vb-projekts/ESP32_BatterieMonitor/Dokumentation/Dokumentation.docx

ESP32 Batterie-Monitor

Projektdokumentation

AZ-Delivery Mini D1 ESP32 | HC-SR04 Ultraschall | 1.30" OLED | Raspberry Pi 5

Erstellt: August 2026

# 1. Projektuberblick

Dieses Projekt realisiert einen mobilen Sensor-Monitor auf Basis eines ESP32-Mikrocontrollers. Der ESP32 wird uber ein DC-DC Buck-Converter-Modul von einer 12V Autobatterie versorgt und misst kontinuierlich Distanz (HC-SR04), Uptime und Batteriespannung. Die Daten werden auf einem OLED-Display angezeigt, uber einen lokalen Webserver bereitgestellt und alle 10 Sekunden an einen Raspberry Pi 5 gesendet, der eine Ubersichts-Webseite anzeigt.

## Komponenten

Komponente | Modell / Typ | Funktion
Mikrocontroller | AZ-Delivery Mini D1 ESP32 (WROOM-32) | Hauptcontroller
Display | 1.30" IIC OLED V2.1 (SH1106, 128x64) | Anzeige Uptime + IP
Ultraschallsensor | HC-SR04 / HC-SR04+ | Distanzmessung
Server | Raspberry Pi 5 (DietPi) | Datenempfang + Webseite
Stromversorgung | 24V/12V zu 5V 5A DC-DC Buck Converter | Spannungsversorgung vom Auto
Batterie | 12V Blei-Saure Autobatterie | Energiequelle

# 2. Hardware - Anschlussdiagramme

## 2.1 OLED Display (1.30" IIC V2.1)

Das Display kommuniziert uber den I2C-Bus. Alle 4 Pins direkt anschliessen - kein Spannungsteiler notig.

OLED Pin | ESP32 Pin | GPIO | Farbe (Empfehlung)
VDD | 3V3 | - | Rot
GND | GND | - | Schwarz
SCK | GPIO22 | SCL | Gelb
SDA | GPIO21 | SDA | Blau

Schaltplan:

ESP32 Mini D1 1.30" IIC OLED V2.1
+------------------+ +------------------+
| 3V3 -----------+-------------+-- VDD |
| GND -----------+-------------+-- GND |
| GPIO21 (SDA) ---+-------------+-- SDA |
| GPIO22 (SCL) ---+-------------+-- SCK |
+------------------+ +------------------+

## 2.2 HC-SR04 Ultraschallsensor

WICHTIG: Den ECHO-Pin pruefen!

HC-SR04+ (mit + oder P): direkt an 3.3V und GPIO anschliessbar

HC-SR04 (ohne +): 5V an VCC, ECHO-Pin benoetigt Spannungsteiler (100kOhm + 27kOhm)

HC-SR04 Pin | ESP32 Pin | GPIO | Hinweis
VCC | 3V3 oder 5V | - | HC-SR04+: 3.3V ok | HC-SR04: 5V benoetigt
GND | GND | - | Gemeinsame Masse!
TRIG | GPIO25 | Output | Direkt anschliessbar
ECHO | GPIO27 | Input | Bei 5V-Versorgung: Spannungsteiler verwenden

Schaltplan:

ESP32 Mini D1 HC-SR04
+------------------+ +------------------+
| 3V3/5V ---------+-------------+-- VCC |
| GND -----------+-------------+-- GND |
| GPIO25 (TRIG) --+-------------+-- TRIG |
| GPIO27 (ECHO) --+--[Teiler]---+-- ECHO |
+------------------+ +------------------+

Spannungsteiler (nur bei 5V-Variante):
ECHO (5V) --- 100kOhm --- GPIO27
|
27kOhm
|
GND

## 2.3 Batteriespannungsmessung (optional)

Misst die Batteriespannung (12V) sicher am ESP32 ADC (max. 3.3V) uber einen Spannungsteiler.

Bauteil | Wert | Anschluss | Zweck
R1 | 100 kOhm | Batterie (+) -> GPIO34 | Spannungsteiler oben
R2 | 27 kOhm | GPIO34 -> GND | Spannungsteiler unten
Zener-Diode | 3.3V | Parallel zu R2 | GPIO-Schutz vor Spannungsspitzen
Kondensator | 100 nF | Parallel zu R2 | Rauschfilter ADC
Messpunkt | GPIO34 | ADC1 - Channel 6 | ADC1 wegen WiFi-Kompatibilitaet!

Schaltplan:

Batterie (+) 12V
|
R1 100kOhm
|
+---------- GPIO34 (ESP32)
|
R2 27kOhm Zener 3.3V 100nF
| | |
GND +-----------+-----------+
(gemeinsame Masse = Buck Converter GND = ESP32 GND)

## 2.4 Stromversorgung - Buck Converter

Das DC-DC Modul wandelt 12V der Autobatterie in 5V USB fuer den ESP32 um.

Anschluss | Von | Nach | Hinweis
Buck IN+ | Batterie (+) | Buck Converter IN+ | Rohspannung 12V
Buck IN- | Batterie (-) | Buck Converter IN- | Gemeinsame Masse!
Buck OUT+ | Buck OUT+ | USB Kabel (+) | 5V stabilisiert
Buck OUT- | Buck OUT- | USB Kabel GND | Masse durchgeschleift
Spannungsteiler | Batterie (+) | R1 -> GPIO34 | VOR dem Buck abgreifen!

WICHTIG: Den Spannungsteiler direkt an der Rohspannung der Batterie anschliessen, NICHT nach dem Buck-Converter (dort waeren es nur noch 5V)!

# 3. Komplette Pin-Belegung ESP32

Ubersicht aller belegten Pins im Projekt:

GPIO | Funktion | Richtung | Angeschlossen an
GPIO21 | I2C SDA | Bidirektional | OLED SDA
GPIO22 | I2C SCL | Output | OLED SCK
GPIO25 | TRIG | Output | HC-SR04 TRIG
GPIO27 | ECHO | Input | HC-SR04 ECHO
GPIO34 | ADC Batterie | Input (ADC1) | Spannungsteiler R1/R2
3V3 | Versorgung | Power | OLED VDD, HC-SR04 VCC (nur HC-SR04+)
GND | Masse | Power | OLED GND, HC-SR04 GND, Spannungsteiler
5V/VIN | Versorgung | Power IN | Buck Converter OUT+ (via USB)

Bewusst NICHT verwendete Strapping-Pins (Boot-Konflikt vermeiden):

GPIO0, GPIO2, GPIO5, GPIO12, GPIO15 - diese Pins nicht fuer externe Komponenten verwenden!

# 4. Software - ESP32 Arduino Code

## 4.1 Verwendete Libraries

Library | Version | Installation | Zweck
U8g2 | 2.36.x | Arduino Library Manager | OLED Display Treiber (SH1106)
WiFi | 3.3.11 | Im ESP32 Core enthalten | WLAN Verbindung
WebServer | 3.3.11 | Im ESP32 Core enthalten | Lokaler HTTP Server
HTTPClient | 3.3.11 | Im ESP32 Core enthalten | HTTP POST an Raspberry Pi
Wire | 3.3.11 | Im ESP32 Core enthalten | I2C Kommunikation

## 4.2 Arduino IDE Einstellungen

Einstellung | Wert
Board | ESP32 Dev Module
Upload Speed | 115200
CPU Frequency | 240 MHz
Flash Frequency | 80 MHz
Flash Size | 4MB
Partition Scheme | Default 4MB with spiffs

WICHTIG: Board muss auf "ESP32 Dev Module" stehen, NICHT auf "D1_MINI32"! Der D1_MINI32 hat keinen Zugriff auf HTTPClient.h.

## 4.3 Konfiguration im Code

// WLAN
const char* ssid = "DeinNetzwerkName";
const char* password = "DeinPasswort";

// Raspberry Pi Server URL
const char* serverUrl = "http://192.168.178.46:5000/api/data";

// Sendeintervall (Millisekunden)
const unsigned long SEND_INTERVAL = 10000; // 10 Sekunden

// Pin-Definitionen
#define I2C_SDA 21 // OLED Daten
#define I2C_SCL 22 // OLED Takt
#define TRIG_PIN 25 // HC-SR04 Trigger
#define ECHO_PIN 27 // HC-SR04 Echo
#define BATT_PIN 34 // Batterie ADC (ADC1!)

// Spannungsteiler
#define R1 100000.0 // 100 kOhm
#define R2 27000.0 // 27 kOhm
#define KALI_FAKTOR 1.05 // Kalibrierung ADC

## 4.4 Funktionen im Code

Funktion | Beschreibung
messeDistanz() | HC-SR04 Messung, gibt Distanz in cm zurueck (-1 = kein Objekt)
messeBatterie() | 16x ADC messen + mitteln, Spannung zurueckrechnen
ladestandText(v) | Spannung in Ladezustand-Text umwandeln (100%, 75% etc.)
uptimeString() | millis() in HH:MM:SS Format umwandeln
sendeAnServer() | HTTP POST mit JSON-Daten an Raspberry Pi senden
handleRoot() | Lokale ESP32-Webseite mit allen Messwerten ausliefern

## 4.5 Ladezustand Autobatterie

Spannung | Ladezustand | Zustand
>= 12.7 V | 100% | Voll geladen
>= 12.4 V | 75% | Gut
>= 12.2 V | 50% | Mittel
>= 12.0 V | 25% | Schwach
>= 11.8 V | Schwach! | Bald leer
< 11.8 V | LEER! | Abschalten - Tiefentladung vermeiden!

# 5. Software - Raspberry Pi Server

## 5.1 Systemvoraussetzungen

Komponente | Version / Info
Betriebssystem | DietPi (Debian-basiert)
Python | 3.11 oder hoeher
Flask | Aktuell (via pip in venv)
Port | 5000 (TCP, muss im Netzwerk erreichbar sein)

## 5.2 Installation auf DietPi

Schritt-fuer-Schritt Installation per SSH:

# 1. python3-venv installieren
sudo apt install python3-venv -y

# 2. Projektordner anlegen
mkdir -p ~/esp32-monitor

# 3. Virtual Environment erstellen
python3 -m venv ~/esp32-monitor/venv

# 4. Virtual Environment aktivieren
source ~/esp32-monitor/venv/bin/activate

# 5. Flask installieren
pip install flask

# 6. server.py erstellen (Code einfuegen)
nano ~/esp32-monitor/server.py

# 7. Testen
python server.py
# -> Webseite: http://<Pi-IP>:5000

## 5.3 Autostart mit systemd

Service-Datei erstellen damit der Server automatisch nach Neustart startet:

# Service-Datei erstellen
sudo nano /etc/systemd/system/esp32-monitor.service

[Unit]
Description=ESP32 Monitor Server
After=network.target

[Service]
# Python aus der venv verwenden!
ExecStart=/home/dietpi/esp32-monitor/venv/bin/python /home/dietpi/esp32-monitor/server.py
WorkingDirectory=/home/dietpi/esp32-monitor
Restart=always
RestartSec=5
User=root

[Install]
WantedBy=multi-user.target

# Service aktivieren und starten
sudo systemctl daemon-reload
sudo systemctl enable esp32-monitor
sudo systemctl start esp32-monitor

# Status pruefen
sudo systemctl status esp32-monitor

# Logs anzeigen
sudo journalctl -u esp32-monitor -f

## 5.4 API Endpunkte

Endpunkt | Methode | Beschreibung
/ | GET | Webseite mit Ubersicht und Nachrichtentabelle
/api/data | POST | Empfangt JSON-Daten vom ESP32

## 5.5 JSON Format (ESP32 -> Pi)

{
"uptime": "00:12:34", // HH:MM:SS seit letztem Neustart
"uptime_ms": 754000, // Millisekunden seit Neustart
"distanz_cm": 42.5, // Distanz in cm (-1 = kein Objekt)
"batterie_v": 12.54, // Batteriespannung in Volt
"ip": "192.168.178.100" // IP-Adresse des ESP32
}

## 5.6 Haeufige Probleme und Loesungen

Problem | Ursache | Loesung
externally-managed-environment | DietPi Python 3.11+ | Virtual Environment (venv) verwenden
SyntaxError Non-UTF-8 | Datei nicht als UTF-8 gespeichert | Datei-Encoding in Editor auf UTF-8 stellen
Port 5000 nicht erreichbar | Firewall oder falscher Port | sudo ufw allow 5000 oder Port pruefen
ESP32 sendet nicht | Falsche Server-IP im Code | serverUrl im ESP32 Code pruefen

## 5.7 Aktualisierungen server.py

sudo systemctl restart esp32-monitor

# 6. Systemarchitektur

AUTOBATTERIE (12V)
|
+---- Buck Converter (12V -> 5V) ---- USB ----> ESP32
|
+---- Spannungsteiler (100k/27k) ------------> GPIO34 (ADC)

ESP32
|-- I2C (GPIO21/22) ----> OLED Display (Uptime + IP)
|-- GPIO25 (TRIG) ------> HC-SR04
|-- GPIO27 (ECHO) <------ HC-SR04
|-- GPIO34 (ADC) <------- Spannungsteiler Batterie
|
+-- WiFi
|
+-- HTTP GET / --> Lokale Webseite (Browser)
+-- HTTP POST /api/data --> Raspberry Pi :5000

RASPBERRY PI 5 (DietPi)
+-- Flask Server :5000
|
+-- /api/data <-- Empfaengt Daten vom ESP32 (alle 10s)
+-- / --> Webseite fuer Browser (Auto-Refresh 5s)

# 7. Wichtige Hinweise und Tipps

## 7.1 Sicherheit

- ESP32 GPIO-Pins vertragen maximal 3.3V! Nie 5V direkt anlegen.

- Batterie-Minus (GND) muss mit ESP32 GND verbunden sein (gemeinsame Masse).

- Spannungsteiler IMMER vor dem Buck-Converter an der Rohspannung abgreifen.

- Zener-Diode 3.3V am ADC-Pin schuetzt vor Spannungsspitzen der Batterie.

- Verpolungsschutz des Buck-Converters schuetzt das Modul, nicht den Spannungsteiler!

## 7.2 ADC Kalibrierung

Der ESP32 ADC ist von Haus aus ca. 5-10% ungenau. Vorgehen zur Kalibrierung:

1. Multimeter an die Batterie halten und echten Wert ablesen.

2. Angezeigten Wert auf der Webseite notieren.

3. KALI_FAKTOR im Code entsprechend anpassen: KALI_FAKTOR = Echter_Wert / Angezeigter_Wert

## 7.3 ADC2 nicht mit WiFi verwenden

Der ESP32 hat ADC1 (GPIO32-39) und ADC2. ADC2 ist gesperrt wenn WiFi aktiv ist! Deshalb GPIO34 (ADC1) fuer die Batteriemessung verwenden.

## 7.4 Strapping-Pins meiden

Folgende GPIOs beim Booten nicht belegen (fuehrt zu Upload-Fehlern):

GPIO0 (Flash-Modus), GPIO2, GPIO5, GPIO12, GPIO15

Symptom: "serial TX path seems to be down" beim Flashen.

## 7.5 5V Pin beim Flashen

Den 5V-Pin des ESP32 (= USB VBUS) beim Flashen nicht mit externen Verbrauchern belasten. Das kann den Upload unterbrechen. Sensor waehrend des Flashens abziehen oder auf 3.3V umstecken.

# 8. Dateien in diesem Projekt-Ordner

Datei | Beschreibung
Dokumentation.docx | Diese Dokumentation
Code/Uptime_Schall.ino | Arduino Code fuer den ESP32 (vollstaendig)
Code/server.py | Python Flask Server fuer den Raspberry Pi

# 9. Batteriespannungsmessung - Loetanleitung

Dieses Kapitel erklaert wie du das Spannungsteiler-Modul fuer die Batteriemessung zusammenlotest. Das Modul wird als kleine eigenstaendige Einheit aufgebaut und dann mit nur 3 Kabeln angeschlossen.

## 9.1 Benoetigt

Bauteil | Wert | Anzahl | Hinweis
Widerstand R1 | 100 kOhm | 1x | Farbringe: Braun-Schwarz-Gelb-Gold
Widerstand R2 | 27 kOhm | 1x | Farbringe: Rot-Violett-Orange-Gold
Zener-Diode | 3,3V (z.B. BZX55C3V3) | 1x | Auf Polaritaet achten! Ring = Kathode
Kondensator | 100 nF (= 0,1 uF) | 1x | Keramik-Typ: keine Polaritaet
Kabel rot | ~20 cm | 1x | Zum Batterie (+)
Kabel schwarz | ~20 cm | 1x | Zu GND
Kabel gelb | ~20 cm | 1x | Zu GPIO34 am ESP32
Lochrasterplatine | klein (ca. 3x2 cm) | 1x | Optional aber empfohlen

## 9.2 Schaltplan Gesamtuebersicht

Der Mittelpunkt (MP) ist die zentrale Loetstelle - dort treffen sich alle Bauteile:

Batterie (+) 12V
|
[R1 100kOhm]
|
MP ────────────────────────► GPIO34 (ESP32)
|
+----+----+----------+
| | |
[R2 27kOhm] [Zener 3,3V] [100nF]
| | |
GND GND GND

MP = Mittelpunkt (R1 + R2 + Zener + Kondensator + GPIO34-Kabel)
GND = Gemeinsame Masse (ESP32 GND = Buck Converter GND = Batterie Minus)

## 9.3 Schritt 1 - R1 und R2 in Reihe loeten

Loete ein Bein von R1 (100kOhm) direkt an ein Bein von R2 (27kOhm). Diese Verbindung ist der Mittelpunkt. Widerstande haben keine Polaritaet.

Batterie(+) MP GND
| | |
[freies Bein R1]──[R1 100kOhm]──[R2 27kOhm]──[freies Bein R2]
^
Hier zusammenloeten = Mittelpunkt!

Tipp: Kuerze die Beine der Widerstande auf ca. 5mm und verdrille sie miteinander bevor du sie lotest - das haelt besser und ist kompakter.

## 9.4 Schritt 2 - Zener-Diode anloeten

Die Zener-Diode kommt parallel zu R2 - also zwischen Mittelpunkt und GND.

WICHTIG - Polaritaet beachten!
Kathode (Ring/Strich auf dem Gehaeuse) --> zum Mittelpunkt (hoehere Spannung)
Anode (Seite ohne Ring) --> zu GND
Falsch herum = kein Schutz fuer den ESP32!

Einbaurichtung der Zener-Diode:

Mittelpunkt ──── Kathode [RING] ──|Z|── Anode ──── GND
^
Strich/Ring auf dem Bauteil
zeigt immer zur hoeher liegenden Spannung

Visuell auf dem Bauteil:
GND <── (kein Ring) ──[===|]── (Ring/Strich) ──> Mittelpunkt

## 9.5 Schritt 3 - Kondensator anloeten

Der 100nF Kondensator kommt ebenfalls zwischen Mittelpunkt und GND.

Keramik-Kondensator (kleines Scheibchen): KEINE Polaritaet - beliebig herum einloeten.
Elko (Zylinder mit Aufschrift): HAT Polaritaet! Minus-Bein (kuerzeres Bein / weisser Strich) zu GND.

Mittelpunkt ──┬── [R2 27kOhm] ── GND
├── [Zener 3,3V] ── GND
└── [100nF Kondensator] ── GND
|
└── Gelbes Kabel zu GPIO34

## 9.6 Schritt 4 - Kabel anloeten

Kabel | Loeten an | Anderes Ende | Hinweis
Rot | Freies Bein R1 | Batterie (+) / Buck IN+ | VOR dem Buck Converter!
Schwarz | Freies Bein R2 + alle GND-Punkte | ESP32 GND | Gemeinsame Masse!
Gelb | Mittelpunkt (MP) | GPIO34 am ESP32 | Das Messsignal

## 9.7 Fertiges Modul - Gesamtbild

ROTES KABEL
zum Batterie (+)
|
[R1 100kOhm]
|
+───────────────MP──────── GELBES KABEL zu GPIO34
| |
[Zener 3,3V] [R2 27kOhm]
| |
| [100nF]
| |
+───────────────+──────── SCHWARZES KABEL zu GND

## 9.8 Anschluss am ESP32 und Batterie

ESP32 Mini D1 Buck Converter / Batterie
+------------------+ +------------------+
| | | |
| GPIO34 <---------+-- Gelb | IN+ (12V) <------+-- Rot
| | | |
| GND <---------+-- Schwarz --+-- IN- (GND) |
| | | |
+------------------+ +------------------+

Erinnerung: Das rote Kabel MUSS an die Rohspannung der Batterie (12V) - also VOR dem Buck Converter. Nach dem Buck Converter waeren es nur 5V und die Messung wuerde keinen Sinn ergeben!

## 9.9 Kontrolle vor dem ersten Einschalten

- Zener-Diode richtig herum? (Ring/Kathode zum Mittelpunkt)
- Kondensator richtig herum? (nur bei Elko - Minus zu GND)
- Rotes Kabel an Batterie (+) VOR dem Buck Converter?
- Schwarzes Kabel an GND (= Buck Converter GND = ESP32 GND)?
- Gelbes Kabel an GPIO34 (nicht GPIO35, 36 oder andere)?
- Kein Kurzschluss zwischen Mittelpunkt und GND ohne Bauteile?

## 9.10 Kalibrierung nach dem Aufbau

Der ESP32 ADC ist ca. 5-10% ungenau. So kalibrierst du:

1. Multimeter an die Batterie halten und echten Wert ablesen (z.B. 12,54V)

2. ESP32 starten und auf der Webseite den angezeigten Wert notieren (z.B. 11,94V)

3. KALI_FAKTOR berechnen: 12,54 / 11,94 = 1,05

4. Im Arduino Code KALI_FAKTOR anpassen und neu flashen

5. Kontrollmessung: Jetzt sollten beide Werte uebereinstimmen

// Im Arduino Code anpassen:
#define KALI_FAKTOR 1.05 // = Echter_Wert / Angezeigter_Wert

// Beispielrechnung:
// Multimeter zeigt: 12,54V
// Webseite zeigt: 11,94V
// KALI_FAKTOR = 12,54 / 11,94 = 1,050

# 10. Einkaufsliste Batteriespannungsmessung - Reichelt Elektronik

Bewaehrte Einkaufsliste bei Reichelt Elektronik (Stand August 2026). Reichelt ermoeglicht stückgenaue Bestellung - ideal fuer Einzelprojekte.

Warum Reichelt statt Amazon?
- Stueckgenaue Bestellung - kein Zwang 100er-Pakete zu kaufen
- Alle 4 Bauteile zusammen: nur ca. 1,53 EUR (statt ~27 EUR bei Amazon)
- Metallschicht-Widerstaende mit 0,1% und 1% Toleranz verfuegbar
- Lieferzeit: 1-2 Werktage ab Lager

## 10.1 Bestelluebersicht

Menge | Artikel-Nr. | Beschreibung | Wert | Toleranz | Einzelpreis | Gesamt
3 | MPR 100K | Widerstand, Metallschicht, 100kOhm, 0207, 0,6W | 100 kOhm | 0,1% | 0,26 EUR | 0,78 EUR
3 | METALL 27,0K | Widerstand, Metallschicht, 27,0kOhm, 0207, 0,6W | 27 kOhm | 1% | 0,07 EUR | 0,21 EUR
3 | BZX 55C3V3 VIS | Zenerdiode, 3,3V, 0,5W, DO-35 | 3,3V | - | 0,04 EUR | 0,12 EUR
3 | C3Z5U 100NA50 | Vielschicht-Kerko, 100nF, 50V, 85°C | 100 nF | - | 0,14 EUR | 0,42 EUR

Gesamtpreis: ca. 1,53 EUR (je 3 Stueck - Ersatz inklusive!)

## 10.2 Detailbeschreibung der Artikel

R1 - MPR 100K | Widerstand 100kOhm Metallschicht

Eigenschaft | Wert
Artikel-Nr. | MPR 100K
Widerstandswert | 100 kOhm
Typ | Metallschicht - praezise und rauscharm
Leistung | 0,6W
Toleranz | 0,1% - extrem praezise
Verwendung | R1: oberer Widerstand (Batterie+ zum Mittelpunkt)
Farbringe | Braun-Schwarz-Gelb-Braun-Braun (100K, 0,1%)

R2 - METALL 27,0K | Widerstand 27kOhm Metallschicht

Eigenschaft | Wert
Artikel-Nr. | METALL 27,0K
Widerstandswert | 27 kOhm
Typ | Metallschicht - praezise und temperaturstabil
Leistung | 0,6W
Toleranz | 1% - 5x genauer als 5%-Variante
Verwendung | R2: unterer Widerstand (Mittelpunkt zu GND)
Farbringe | Rot-Violett-Orange-Braun (27K, 1%)
Vorteil vs. 5% | Messfehler max. +-0,04V statt +-0,2V - und guenstiger!

Vergleich: METALL 27,0K (1%) vs. 1W 27K (5%)
1W 27K (Metalloxyd, 5%): 0,19 EUR - Messfehler bis +-0,2V
METALL 27,0K (Metallschicht, 1%): 0,07 EUR - Messfehler bis +-0,04V
Fazit: Besser UND guenstiger - klare Empfehlung fuer METALL 27,0K!

Zener-Diode - BZX 55C3V3 VIS | 3,3V Zenerdiode

Eigenschaft | Wert
Artikel-Nr. | BZX 55C3V3 VIS
Zenerspannung | 3,3V
Leistung | 0,5W
Gehaeuse | DO-35 - kleines axiales Glasgehaeuse
Verwendung | Ueberspannungsschutz GPIO34 (parallel zu R2)
Einbau | POLARITAET! Ring/Strich = Kathode = zum Mittelpunkt

Merkhilfe: Schwarzer Ring = Kathode = zeigt zum Mittelpunkt
Seite ohne Ring = Anode = zeigt zu GND

Kondensator - C3Z5U 100NA50 | Vielschicht-Kerko 100nF

Eigenschaft | Wert
Artikel-Nr. | C3Z5U 100NA50
Kapazitaet | 100 nF = 0,1 uF
Spannungsfestigkeit | 50V
Temperatur | bis 85°C
Typ | Vielschicht-Keramik - keine Polaritaet!
Verwendung | Rauschfilter am ADC-Pin GPIO34 (parallel zu R2)
Einbau | Beliebig herum - kein Plus/Minus

## 10.3 Spannungsberechnung mit diesen Bauteilen

Kontrolle: Spannung an GPIO34 im sicheren Bereich (max. 3,3V)?

Batteriespannung | Spannung an GPIO34 | Sicher fuer ESP32?
10,5V (Tiefentladung) | 10,5V x 27k / 127k = 2,23V | Ja
11,8V (fast leer) | 11,8V x 27k / 127k = 2,51V | Ja
12,0V (25%) | 12,0V x 27k / 127k = 2,55V | Ja
12,7V (voll) | 12,7V x 27k / 127k = 2,70V | Ja
14,4V (beim Laden) | 14,4V x 27k / 127k = 3,06V | Ja - knapp unter 3,3V
15,0V (max. Ladung) | 15,0V x 27k / 127k = 3,19V | Ja - Zener greift ein

Fazit: Alle Bauteile perfekt gewaehlt!
- Beide Widerstaende Metallschicht: praezise und temperaturstabil
- Toleranz 0,1% + 1%: Messfehler max. +-0,04V vor Kalibrierung
- Selbst bei 15V Ladespannung bleibt GPIO34 unter 3,3V
- Gesamtkosten: nur 1,53 EUR fuer je 3 Stueck aller Bauteile

# 11. Display Ein/Aus Button auf der Webseite (v1.3)

Ab Version 1.3 kann das OLED-Display direkt ueber die Webseite des ESP32 ein- und ausgeschaltet werden. Das spart Strom und ist praktisch wenn das Display gerade nicht benoetigt wird.

Changelog:
v1.0 - Grundversion: Uptime, Distanz, Webserver
v1.1 - HTTP POST an Raspberry Pi
v1.2 - Batteriespannungsmessung
v1.3 - Display Ein/Aus Button auf Webseite <-- NEU

## 11.1 Funktionsprinzip

Der ESP32 bekommt zwei neue URL-Endpunkte. Beim Klick auf den Button ruft der Browser einen dieser Endpunkte auf, der ESP32 schaltet das Display und leitet den Browser zurueck zur Startseite.

Browser klickt "Ausschalten"
|
GET http://ESP32-IP/display/off
|
ESP32: u8g2.setPowerSave(1) --> Display physisch AUS
displayAn = false
Redirect zu "/"
|
Webseite zeigt: "AUS" + Button "Einschalten"

Browser klickt "Einschalten"
|
GET http://ESP32-IP/display/on
|
ESP32: u8g2.setPowerSave(0) --> Display physisch AN
displayAn = true
Redirect zu "/"
|
Webseite zeigt: "AN" + Button "Ausschalten"

u8g2.setPowerSave(1) schaltet das Display physisch aus - es verbraucht
dann kaum noch Strom. Ideal wenn der ESP32 an der Autobatterie laeuft!

## 11.2 Aenderungen im Code (Uebersicht)

Was | Wo im Code | Details
Globale Variable | Ganz oben bei Variablen | bool displayAn = true;
Handler-Funktion 1 | Neue Funktion handleDisplayOn() | setPowerSave(0), Redirect zu /
Handler-Funktion 2 | Neue Funktion handleDisplayOff() | setPowerSave(1), Redirect zu /
Routen registrieren | In setup() | server.on("/display/on/off", ...)
Button im HTML | In handleRoot() | Neue Card mit Status + Button
Loop absichern | Display-Update im loop() | && displayAn hinzugefuegt
POST erweitert | In sendeAnServer() | "display_an": true/false im JSON

## 11.3 Neue Code-Abschnitte

1. Globale Variable:

bool displayAn = true; // true = AN, false = AUS

2. Handler-Funktionen:

void handleDisplayOn() {
displayAn = true;
u8g2.setPowerSave(0); // Display einschalten
server.sendHeader("Location", "/");
server.send(302, "text/plain", "");
}

void handleDisplayOff() {
displayAn = false;
u8g2.setPowerSave(1); // Display ausschalten
server.sendHeader("Location", "/");
server.send(302, "text/plain", "");
}

3. Routen in setup():

server.on("/", handleRoot);
server.on("/display/on", handleDisplayOn);
server.on("/display/off", handleDisplayOff);
server.begin();

4. Loop absichern:

// Display nur aktualisieren wenn es AN ist:
if (jetzt - letzteAnzeige >= 500 && displayAn) {
// ... Display-Code unveraendert ...
}

5. Button-HTML (neue Card in handleRoot()):

// Display-Status Karte - zeigt AN oder AUS + passenden Button
if (displayAn) {
html += "<div class=\"card-value status-an\">AN</div>";
html += "<a href=\"/display/off\" class=\"btn btn-off\">Ausschalten</a>";
} else {
html += "<div class=\"card-value status-aus\">AUS</div>";
html += "<a href=\"/display/on\" class=\"btn btn-on\">Einschalten</a>";
}

## 11.4 Webseiten-Layout mit Button

+----------------------------------------------------+
| ESP32 Dashboard |
| * Live - aktualisiert alle 2s |
+----------------------------------------------------+
| +----------+ +----------+ +----------+ |
| | Uptime | | Distanz | | Batterie | |
| | 00:12:34 | | 42.5 cm | | 12.54V | |
| +----------+ +----------+ +----------+ |
| |
| +------------------+ |
| | Display | |
| | AN (gruen) | <-- Status |
| | [ Ausschalten ] | <-- Button |
| +------------------+ |
+----------------------------------------------------+

Nach Klick "Ausschalten":
| | AUS (rot) |
| | [ Einschalten ] | <-- Button gruen

## 11.5 URL-Endpunkte

URL | Aktion | Rueckgabe
/ | Webseite anzeigen | HTML Seite
/display/on | Display einschalten | Redirect zu /
/display/off | Display ausschalten | Redirect zu /

Tipp: Die URLs koennen auch direkt im Browser aufgerufen werden:
http://<ESP32-IP>/display/off --> Display sofort ausschalten
http://<ESP32-IP>/display/on --> Display sofort einschalten
Das funktioniert auch ohne die Webseite zu oeffnen!
