vb-projekts/ESP32_BatterieMonitor/(commit log)

2026-08-06 [feature] Neuste Version mit Display-Button hinzugefügt
2026-08-09 [feature] Eingabe Kalibrierungsfaktor für Batteriespannung möglich
    [feature] Display ein/ausschaltbar
    [feature] Server geändert. Status mehrerer Boards ist möglich
2026-08-11 [feature] neue Arduino Projektdatei LJ18A3 hinzugefügt
    [feature] OTA - Updatefunktion angepasst
2026-08-24 [feature] Online -Anzeige in die Weboberfläche hinzugefügt
2026-08-25 [feature] Sendeinterverall erhöht
    [bug] Drehen des Wasserrads ohne "schwingen"
    [Uptime_LJ18A3.ino]
2026-08-25 [feature] Adminseite hingefügt
    [bug] JSON angepasst impulseSession + liter_session raus (waren immer identisch mit Gesamt)
    [Uptime_LJ18A3.ino]
2026-08-25 [bug] Durchfluss "geglättet"
    [bug] Wasserrad springt nicht mehr
2026-09-27 Geänderte Dateien:
    /ESP/Webserver/server.py (Version 2.9 → 3.0)
    Garage-Device-Initialisierung erweitert mit cmd_trigger_tor1 und cmd_trigger_tor2 Feldern
    Existierende Befehle bleiben erhalten (wichtig für den Datenaustausch)
    /ESP/Garage/Garage_Control.ino (Version 1.1 → 1.2)
    Payload-Verarbeitung mit Serial-Debug-Ausgaben erweitert
    Zeigt an: [GARAGE] Befehl für Tor X empfangen - triggere Relais
2026-09-27 Echte Bilder der Autos hinterlegt
2026-09-27 Layout Web UI der Garagenseite angepasst:
    Überschrift:
    ❌ Vorher: Doppelgarage (192.168.178.144)
    ✅ Nachher: 🏠 Doppelgarage (ohne IP, mit Garage-Symbol)
    Tor-Bezeichnungen:
    ❌ Vorher: Tor 1 - Ford Focus (Blau)
    ✅ Nachher: Tor 1 - Ford Focus
    ❌ Vorher: Tor 2 - BMW (Schwarz)
    ✅ Nachher: Tor 2 - BMW
    Button-Position:
    ✅ Buttons Taster 1 und Taster 2 sind jetzt oben zwischen Tor-Text und visueller Box
    Status-Anzeige (FREI/BELEGT):
    ✅ FREI: Grün, fett, größer (1.1em)
    ✅ BELEGT: Rot, fett, größer (1.1em)
    ✅ cm-Angabe entfernt
    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
2026-09-27 ✅ FEATURES
    ✓ Automatische Fahrt-Erfassung
    ✓ Stabilitätsprüfung (5 Sekunden)
    ✓ Separate Datenbank (garage.db) & Inkl. Skripte zum erstellen der Db und Tabellen
    ✓ Ein-/Ausblendbare History-Tabelle
    ✓ Formatierte Zeitstempel & Dauer
    ✓ Auto-Symbole (Ford/BMW)
    ✓ API-Endpoint /api/garage/history
2026-10-10 [bugfix] Fahrtenbuch bei Garage wird jetzt geführt
    [feature] neue Oberfläche SQL Navigator hinzugefügt
